montoyatim01/TimTime/Board/TimTime.kicad_pcb

## KiCad design Board/TimTime.kicad_pcb (2022-02-27)

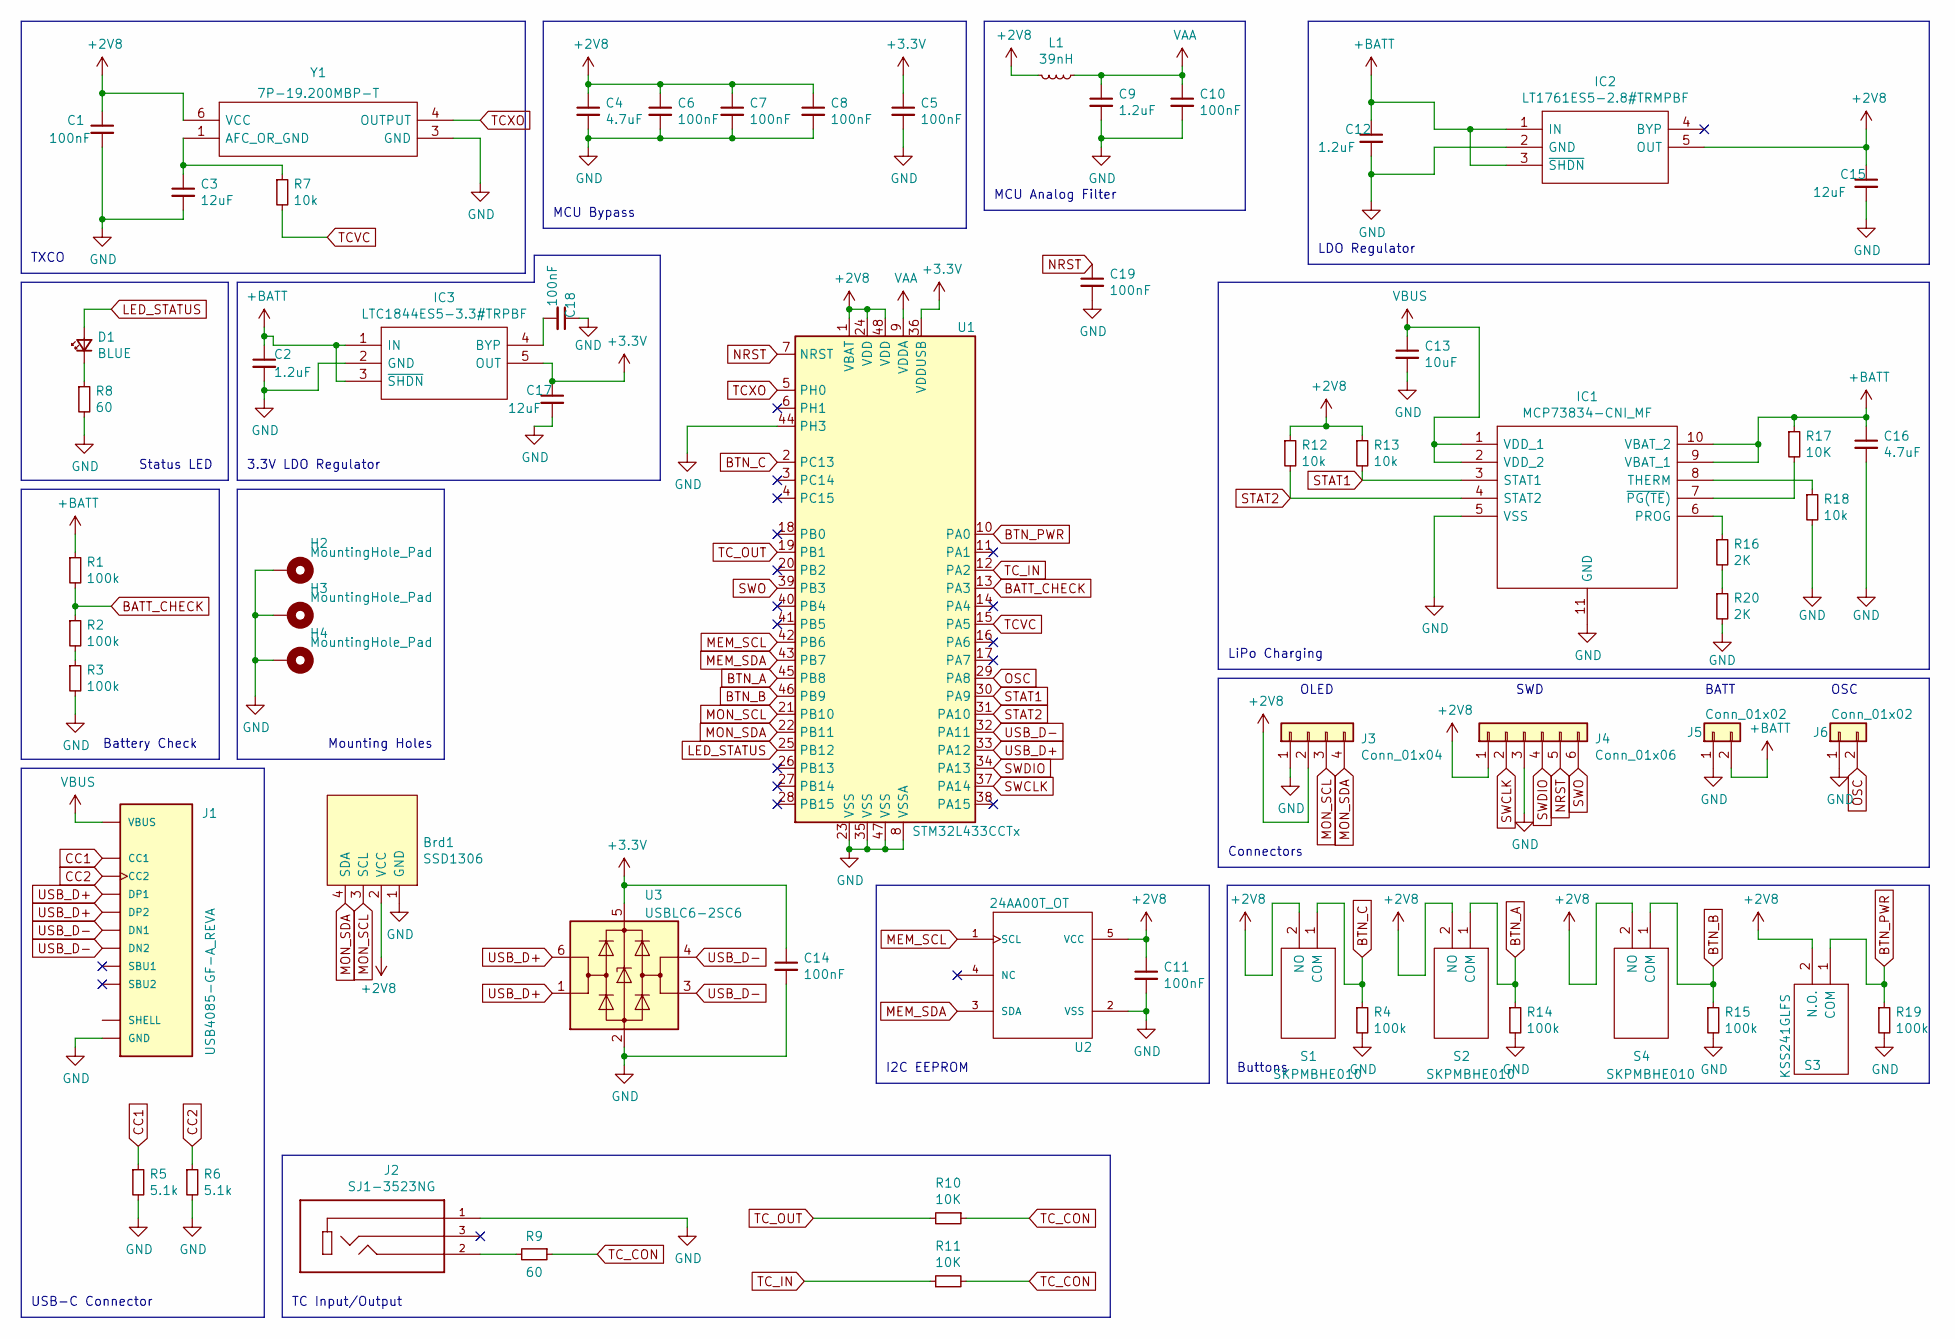
[picture p1: schematic TimTime.kicad_sch, TimTime Lockit]

Parts:
Brd1: SSD1306; 128x64OLED
C1, C5, C6, C7, C8, C10, C11, C14, C18, C19: 100nF; C_0603_1608Metric_Pad1.08x0.95mm_HandSolder
C2, C9, C12: 1.2uF; C_0603_1608Metric_Pad1.08x0.95mm_HandSolder
C3, C15, C17: 12uF; C_0603_1608Metric_Pad1.08x0.95mm_HandSolder
C4, C16: 4.7uF; C_0603_1608Metric_Pad1.08x0.95mm_HandSolder
C13: 10uF; C_0603_1608Metric_Pad1.08x0.95mm_HandSolder
D1: BLUE; LED_1206_3216Metric_Pad1.42x1.75mm_HandSolder
H2, H3, H4: MountingHole_Pad; MountingHole_3.2mm_M3_Pad_Via
IC1: MCP73834-CNI_MF; SON50P300X300X100-11N-D; Manufacturer_Part_Number MCP73834-CNI/MF; Mouser Part Number 579-MCP73834-CNI/MF
IC2: LT1761ES5-2.8#TRMPBF; SOT95P280X100-5N; Manufacturer_Part_Number LT1761ES5-2.8#TRMPBF; Mouser Part Number 584-1761ES5-2.8TMPF
IC3: LTC1844ES5-3.3#TRPBF; SOT95P280X100-5N; Manufacturer_Part_Number LT1761ES5-2.8#TRMPBF; Mouser Part Number 584-1761ES5-2.8TMPF
J1: USB4085-GF-A_REVA; GCT_USB4085-GF-A_REVA; PARTREV A2
J2: SJ1-3523NG; CUI_SJ1-3523NG; PARTREV 1.01
J3: Conn_01x04; PinHeader_1x04_P2.54mm_Vertical
J4: Conn_01x06; PinHeader_1x06_P2.54mm_Vertical
J5, J6: Conn_01x02; PinHeader_1x02_P2.54mm_Vertical
L1: 39nH; L_0603_1608Metric_Pad1.05x0.95mm_HandSolder
R1, R2, R3, R4, R14, R15, R19: 100k; R_0603_1608Metric_Pad0.98x0.95mm_HandSolder
R5, R6: 5.1k; R_0603_1608Metric_Pad0.98x0.95mm_HandSolder
R7, R12, R13, R18: 10k; R_0603_1608Metric_Pad0.98x0.95mm_HandSolder
R8, R9: 60; R_0603_1608Metric_Pad0.98x0.95mm_HandSolder
R10, R11, R17: 10K; R_0603_1608Metric_Pad0.98x0.95mm_HandSolder
R16, R20: 2K; R_0603_1608Metric_Pad0.98x0.95mm_HandSolder
S1, S2, S4: SKPMBHE010; Manufacturer_Part_Number SKPMBHE010; Mouser Part Number 688-SKPMBHE010
S3: KSS241GLFS; Manufacturer_Part_Number KSS241GLFS; Mouser Part Number 611-KSS241GLFS
U1: STM32L433CCTx; LQFP-48_7x7mm_P0.5mm
U2: 24AA00T_OT; SOT95P280X145-5N
U3: USBLC6-2SC6; SOT-23-6
Y1: 7P-19.200MBP-T; 7P25000MBPT; Manufacturer_Part_Number 7P-25.000MBP-T; Mouser Part Number 717-7P-25.000MBP-T

Connections:
+2V8: Brd1.2 (VCC), C1.1, C4.1, C6.1, C7.1, C8.1, C11.1, C15.1, IC2.5 (OUT), J3.2, J4.1, L1.2, R12.1, R13.1, S1.2 (NO), S2.2 (NO), S3.2 (N.O.), S4.2 (NO), U1.1 (VBAT), U1.24 (VDD), U1.48 (VDD), U2.5 (VCC), Y1.6 (VCC)
+3V3: C5.1, C14.1, C17.1, IC3.5 (OUT), U1.36 (VDDUSB), U3.5 (VBUS)
+BATT: C2.1, C12.1, C16.1, IC1.9 (VBAT_1), IC1.10 (VBAT_2), IC2.1 (IN), IC2.3 (~SHDN), IC3.1 (IN), IC3.3 (~SHDN), J5.2, R1.1, R17.1
BATT_CHECK: R1.2, R2.1, U1.13 (PA3)
BTN_A: R14.1, S2.1 (COM), U1.45 (PB8)
BTN_B: R15.1, S4.1 (COM), U1.46 (PB9)
BTN_C: R4.1, S1.1 (COM), U1.2 (PC13)
BTN_PWR: R19.1, S3.1 (COM), U1.10 (PA0)
CC1: J1.A5 (CC1), R5.1
CC2: J1.B5 (CC2), R6.1
GND: Brd1.1 (GND), C1.2, C2.2, C3.2, C4.2, C5.2, C6.2, C7.2, C8.2, C9.2, C10.2, C11.2, C12.2, C13.2, C14.2, C15.2, C16.2, C17.2, C18.1, C19.2, H2.1, H3.1, H4.1, IC1.5 (VSS), IC1.11 (GND), IC2.2 (GND), IC3.2 (GND), J1.A1 (GND), J1.A12 (GND), J1.B1 (GND), J1.B12 (GND), J2.1, J3.1, J4.3, J5.1, J6.1, R3.2, R4.2, R5.2, R6.2, R8.2, R14.2, R15.2, R18.2, R19.2, R20.2, U1.8 (VSSA), U1.23 (VSS), U1.35 (VSS), U1.44 (PH3), U1.47 (VSS), U2.2 (VSS), U3.2 (GND), Y1.3 (GND)
LED_STATUS: D1.2 (A), U1.25 (PB12)
MEM_SCL: U1.42 (PB6), U2.1 (SCL)
MEM_SDA: U1.43 (PB7), U2.3 (SDA)
MON_SCL: Brd1.3 (SCL), J3.3, U1.21 (PB10)
MON_SDA: Brd1.4 (SDA), J3.4, U1.22 (PB11)
NRST: C19.1, J4.5, U1.7 (NRST)
unnamed: C3.1, R7.1, Y1.1 (AFC_OR_GND)
unnamed: C18.2, IC3.4 (BYP)
unnamed: D1.1 (K), R8.1
unnamed: IC1.6 (PROG), R16.1
unnamed: IC1.7 (~PG(TE)), R17.2
unnamed: IC1.8 (THERM), R18.1
unnamed: J1.P1 (SHELL), J1.P2 (SHELL), J1.P3 (SHELL), J1.P4 (SHELL)
unnamed: J2.2, R9.2
unnamed: R2.2, R3.1
unnamed: R16.2, R20.1
OSC: J6.2, U1.29 (PA8)
STAT1: IC1.3 (STAT1), R13.2, U1.30 (PA9)
STAT2: IC1.4 (STAT2), R12.2, U1.31 (PA10)
SWCLK: J4.2, U1.37 (PA14)
SWDIO: J4.4, U1.34 (PA13)
SWO: J4.6, U1.39 (PB3)
TCVC: R7.2, U1.15 (PA5)
TCXO: U1.5 (PH0), Y1.4 (OUTPUT)
TC_CON: R9.1, R10.1, R11.2
TC_IN: R11.1, U1.12 (PA2)
TC_OUT: R10.2, U1.19 (PB1)
USB_D+: J1.A6 (DP1), J1.B6 (DP2), U1.33 (PA12), U3.1 (I/O1), U3.6 (I/O1)
USB_D-: J1.A7 (DN1), J1.B7 (DN2), U1.32 (PA11), U3.3 (I/O2), U3.4 (I/O2)
VAA: C9.1, C10.1, L1.1, U1.9 (VDDA)
VBUS: C13.1, IC1.1 (VDD_1), IC1.2 (VDD_2), J1.A4 (VBUS), J1.A9 (VBUS), J1.B4 (VBUS), J1.B9 (VBUS)

Notes on the sheet:
TC Input/Output
Connectors
TXCO
Mounting Holes
LiPo Charging
Battery Check
USB-C Connector
3.3V LDO Regulator
MCU Bypass
SWD
LDO Regulator
Status LED
MCU Analog Filter
OLED
OSC
Buttons
I2C EEPROM
BATT

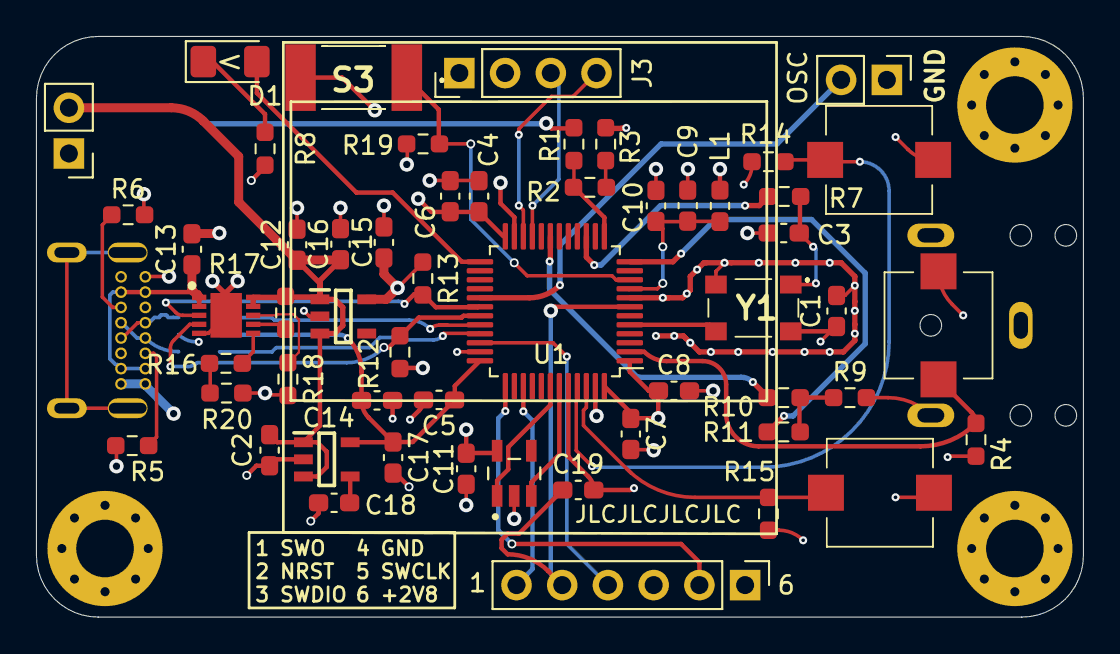
[picture p2: board TimTime.kicad_pcb from above]

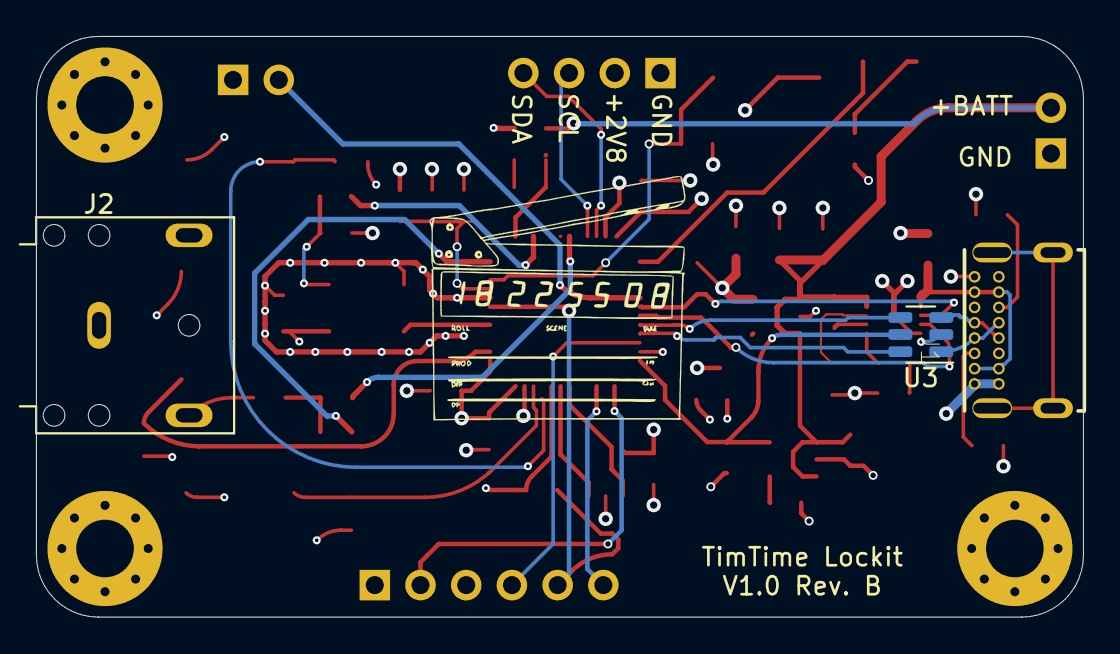
[picture p3: board TimTime.kicad_pcb from below]

Board: 4 copper layers, 58.2 x 32.3 mm, 61 parts (3 on the bottom side), 42 nets.
