montoyatim01/TimTime/Firmware/TimTime.ioc

Mcu.UserName=STM32L433CCTx
PA0.Signal=SYS_WKUP1
PA10.GPIO_Label=STAT2
PA10.Signal=GPIO_Input
PA11.Signal=USB_DM
PA12.Signal=USB_DP
PA2.GPIO_Label=TC_IN
PA2.Signal=S_TIM2_CH3
PA3.GPIO_Label=BATT_CHECK
PA3.Signal=ADCx_IN8
PA5.GPIO_Label=TCVC
PA5.Signal=COMP_DAC12_group
PA8.GPIO_Label=OSC
PA8.Signal=RCC_MCO
PA9.GPIO_Label=STAT1
PA9.Signal=GPIO_Input
PB1.GPIO_Label=TC_OUT
PB1.Signal=GPIO_Output
PB10.GPIO_Label=MON_SCL
PB10.Signal=I2C2_SCL
PB11.GPIO_Label=MON_SDA
PB11.Signal=I2C2_SDA
PB12.GPIO_Label=LED_STATUS
PB12.Signal=GPIO_Output
PB6.GPIO_Label=MEM_SCL
PB6.Signal=I2C1_SCL
PB7.GPIO_Label=MEM_SDA
PB7.Signal=I2C1_SDA
PB8.GPIO_Label=BTN_A
PB8.Signal=GPIO_Input
PB9.GPIO_Label=BTN_B
PB9.Signal=GPIO_Input
PC13.Signal=GPIO_Input
