montoyatim01/TimTime/Firmware/Inc/main.h

#define TC_IN_Pin GPIO_PIN_2
#define TC_IN_GPIO_Port GPIOA
#define BATT_CHECK_Pin GPIO_PIN_3
#define BATT_CHECK_GPIO_Port GPIOA
#define TCVC_Pin GPIO_PIN_5
#define TCVC_GPIO_Port GPIOA
#define TC_OUT_Pin GPIO_PIN_1
#define TC_OUT_GPIO_Port GPIOB
#define MON_SCL_Pin GPIO_PIN_10
#define MON_SCL_GPIO_Port GPIOB
#define MON_SDA_Pin GPIO_PIN_11
#define MON_SDA_GPIO_Port GPIOB
#define LED_STATUS_Pin GPIO_PIN_12
#define LED_STATUS_GPIO_Port GPIOB
#define OSC_Pin GPIO_PIN_8
#define OSC_GPIO_Port GPIOA
#define STAT1_Pin GPIO_PIN_9
#define STAT1_GPIO_Port GPIOA
#define STAT2_Pin GPIO_PIN_10
#define STAT2_GPIO_Port GPIOA
#define MEM_SCL_Pin GPIO_PIN_6
#define MEM_SCL_GPIO_Port GPIOB
#define MEM_SDA_Pin GPIO_PIN_7
#define MEM_SDA_GPIO_Port GPIOB
#define BTN_A_Pin GPIO_PIN_8
#define BTN_A_GPIO_Port GPIOB
#define BTN_B_Pin GPIO_PIN_9
#define BTN_B_GPIO_Port GPIOB
#define uMax0 651 // Any time greater than this is to big
#define uMax1 390 // Midpoint timing between a 1 and 0 bit length
#define uMin1 130 // Any time less than this is to short
