montoyatim01/TimTime/Firmware/Inc/Display.h

#ifndef __DISPLAY_H
#define __DISPLAY_H
#include <stdint.h>
typedef enum{
    d_off = 0x0,
    d_home = 0x1,
    d_menu = 0x2,
    d_lock = 0x3,
    d_power = 0x4,
    d_rateWarn = 0x5,
    d_offsetWarn = 0x6,
    d_rejamWarn = 0x7,
    d_calibration = 0x8,
    d_calOK = 0x9,
    d_calFail = 0x10,
    d_calReadFail = 0x11,
    d_userBits = 0x12
} displayMode;
//typedef enum displayMode displayMode;




void updateDisplay(uint8_t state);
void displayOff();
void displayMain();
void displayLocked();
void displayPower();
void displayMenu();
void displayConfirmationRateChange();
void displayConfirmationOffsetChange();
void displayConfirmationRejam();
void displayUnlock();
void displayBattery();
void timecodeDisplay();
void initDisplay();

void displayCalibration();
void displayCalibrationOK();
void displayCalibrationFail();
void displayCalibrationReadFail();

void displayUserBitsMenu();

extern char tcDisplay[11];
#endif
