montoyatim01/TimTime/(commit log)

2021-05-01 V01 Schematic
    Initial schematic design
    [TimTime.kicad_pcb, TimTime.sch]
2021-05-04 Initial Board Layout
    Rough pass of component layout. Working down the overall footprint of the device. Also updated a couple components in the schematic.
    [TimTime.sch]
2021-06-27 Layout/Routing
    Full V01 layout and routing
    [TimTime.kicad_pcb]
2021-07-08 Update layout
    Smaller footprint
    [TimTime.kicad_pcb, TimTime.sch]
2021-08-12 Updated routing
    [TimTime.kicad_pcb, TimTime.sch]
2021-08-14 V02 routing. VddUSB
    [TimTime.kicad_pcb, TimTime.sch]
2021-08-16 Finalize V02 routing
    [TimTime.kicad_pcb]
2021-08-18 Add additional button, include libraries
    [TimTime.kicad_pcb, TimTime.sch]
2021-10-17 V01 Gerbers
    [TimTime-B_Cu.gbl, TimTime-B_Mask.gbs, TimTime-B_Paste.gbp, TimTime-B_SilkS.gbo, TimTime-Edge_Cuts.gm1, TimTime-F_Cu.gtl, TimTime-F_Mask.gts, TimTime-F_Paste.gtp]
2021-11-13 Firmware Stems
    [TimTime.csv, TimTimeval.csv]
2022-01-24 Screen timeout, lock, initial power on/off
2022-01-25 Battery implementation, new method for button holds
2022-01-26 EEPROM Implementation, Calibration setting menu
2022-01-31 Finish calibration menus/checks, start user bit menu implementation
2022-02-27 V01B Board
    [TimTime-B_Cu.gbl, TimTime-B_Mask.gbs, TimTime-B_Paste.gbp, TimTime-B_Silkscreen.gbo, TimTime-Edge_Cuts.gm1, TimTime-F_Cu.gtl, TimTime-F_Mask.gts, TimTime-F_Paste.gtp]
